bgamari/solar-charger-v2/(list of files, drawings)

Other design files:
solar-charger-2.pcb
