bgamari/solar-charger-v2/firmware/clock.c

#include "clock.h"
#include <libopencm3/cm3/systick.h>
#include <libopencm3/cm3/nvic.h>

volatile uint32_t msTicks;      /* counts 1ms timeTicks */

void init_systick()
{
    systick_set_reload(CLOCKRATE / 8 / 1000);
    systick_interrupt_enable();
    systick_counter_enable();
}

void delay_ms(unsigned int ms) {
    uint32_t curTicks;
    curTicks = msTicks;
    while ((msTicks - curTicks) < ms);
}

void sys_tick_handler(void) {
    msTicks++;
}
