bgamari/solar-charger-v2/(commit log)

2014-06-28 start project solar-charger-2
    [solar-charger-2.sch]
2014-06-29 More shuffling
    [solar-charger-2.sch]
2014-06-29 First pass on board artwork
    [solar-charger-2.pcb, solar-charger-2.sch]
2014-06-29 USB connector added
    [solar-charger-2.pcb, solar-charger-2.sch]
2014-06-29 Add temperature sensor
    [solar-charger-2.pcb, solar-charger-2.sch]
2014-06-29 Fix LED names
    [solar-charger-2.pcb, solar-charger-2.sch]
2014-06-29 Shuffle labels
    [solar-charger-2.pcb]
2014-06-29 Enlarge Panasonic cap footprint
    [solar-charger-2.pcb]
2014-06-30 Add buttons
    [solar-charger-2.pcb, solar-charger-2.sch]
2014-06-30 Clear solder mask under regulators
    [solar-charger-2.pcb]
2014-06-30 Fix component values
    [solar-charger-2.pcb, solar-charger-2.sch]
2014-06-30 Add more notes
    [solar-charger-2.sch]
2014-06-30 More bypassing
    [solar-charger-2.pcb, solar-charger-2.sch]
2014-06-30 More silk shuffling
    [solar-charger-2.pcb]
2014-06-30 Clean up grounds
    [solar-charger-2.pcb]
2014-07-01 Oops, fix TEMP input
    PB2 is unfortunately not an ADC input. Move TEMP to PB0
    [solar-charger-2.pcb, solar-charger-2.sch]
2014-07-01 Add thermistor lookup table
2014-07-01 Mark thermistor lut as static
2014-07-16 Remove VBAT switching
    The high battery voltage made things rather tricky and with enough
    resistance and capacitance the measurement is quite trivial.
    [solar-charger-2.pcb, solar-charger-2.sch]
2014-07-17 Fix divider values
    [solar-charger-2.pcb, solar-charger-2.sch]
2014-07-17 Add UART to JTAG connector
    [solar-charger-2.pcb, solar-charger-2.sch]
2014-07-18 Fix JTAG pinning
    [solar-charger-2.pcb, solar-charger-2.sch]
2014-07-18 Fix silk
    [solar-charger-2.pcb]
2014-07-19 Enlarge board
    [solar-charger-2.pcb]
2014-07-19 Shuffle layout
    [solar-charger-2.pcb]
2014-07-19 More silk
    [solar-charger-2.pcb]
2014-07-19 Show name
    [solar-charger-2.pcb]
2014-07-23 Allow reworking of BOOT0
    [solar-charger-2.pcb]
2014-07-23 Add filter cap to TEMP
    [solar-charger-2.pcb, solar-charger-2.sch]
2014-07-23 Add filter cap to Vin
    [solar-charger-2.pcb, solar-charger-2.sch]
2014-07-24 Simplify traces
    [solar-charger-2.pcb]
2014-07-24 Bump down C1 footprint size
    [solar-charger-2.pcb, solar-charger-2.sch]
2014-07-24 Pull down BOOT1
    [solar-charger-2.pcb, solar-charger-2.sch]
2014-07-24 Add pull-down to BOOT0
    [solar-charger-2.pcb, solar-charger-2.sch]
2014-07-24 Version 3.0
    [solar-charger-2.pcb]
2014-07-27 Fix DAC argument order
    Damn you C
    [charge.c]
2014-07-27 Ensure DAC and ADC clocks get enabled
2014-07-27 timeout: TIM5 apparently doesn't exist on this chip
    Use TIM4 instead.
    [timeout.c]
2014-07-27 Be more careful with ADC power on/off
2014-07-27 adc: Silly logic error
    [adc.c]
2014-07-27 Finally have adc sampling
2014-07-27 adc: Kill dead code
2014-07-27 adc: Fix sampling
    It was still quite wrong
    [adc.c]
2014-07-27 timeout: Move callbacks out of interrupt context
2014-07-27 More ADC fixes
2014-07-28 Rework charging modes
2014-07-28 charge: Fix feedback period
    [charge.c]
2014-07-28 charge: Ensure we reset last_power
    [charge.c]
2014-07-28 usart: Implement printf
2014-07-28 charge: Fix ADC units
    [charge.c]
2014-07-28 timeout: Fix logic error
    [timeout.c]
2014-07-28 charge: Add LOG macro
2014-07-28 charge: Rework
2014-07-28 adc: Manually scan through channels
    I was seeing overflows for unknown reasons
2014-07-28 charge: Disable battery temperature checks for now
2014-07-28 charge: Constraint charge_offset
2014-07-28 charge: Account for voltage sense gain
2014-07-28 adc: Average over samples
2014-07-28 charge: Fix current gain
    [charge.c]
2014-07-29 Reduce current sense resistance
    Previously could only sense up to 164mA
    [solar-charger-2.pcb, solar-charger-2.sch]
2014-07-29 Charging feedback appears to work
2014-07-29 charge: Fix current sense resistor value
    [charge.c]
2014-07-29 Choose more reasonable initial value for charge_offset
2014-08-04 charge: Current in microamps
2014-08-04 charge: Make threshold power configurable
2014-08-04 Be smarter about initialization
    Start offset near battery voltage
2014-08-04 charge: Document variables
2014-08-04 charge: Ensure perturbation sign is correct after reset
    [charge.c]
2014-08-04 charge: Kill dead code
2014-08-05 charge: Refactor ADC channel mappings and sample Vin
2014-08-05 Increase charge restart time
2014-08-05 charge: Factor out sensor sampling
2014-08-05 charge: Export sample cache
2014-08-05 Use button to query charge state
2014-08-05 Fix R6 value
    2.2kohm is close enough to 2.5kohm
    [solar-charger-2.pcb, solar-charger-2.sch]
2014-08-09 Use 56k and 10k for USB regulator
    [solar-charger-2.pcb, solar-charger-2.sch]
2014-08-09 charge: Update pinning
2014-08-09 adc: Ensure last sample get written
2014-08-09 charge: Add debug output
2014-08-09 charge: Add newline
2014-08-09 Fix charge voltage to offset calculation
    [charge.c]
2014-08-09 charge: Fix charge_en pin
    [charge.c]
2014-08-09 charge: Reset to slightly above battery voltage
    [charge.c]
2014-08-09 charge: Add manual mode
2014-08-09 usart: thread safety
2014-08-10 More room around 0603s
    [solar-charger-2.pcb]
2014-08-13 Kill CHARGE_EN pin
    This broke the charge regulator as it dragged the EN pin to 3.3V.
    Unfortunately the maximum pin voltage is 5V, so we can't use the open
    drain mode. Oh well, I really didn't need CHARGE_EN anyways as we can
    just adjust the voltage setpoint
    [solar-charger-2.pcb, solar-charger-2.sch]
2014-08-14 Fix trickle current setpoint
    [charge.c]
2014-08-19 charge: Set maximum charge regulator current limit
2014-08-19 charge: Move termination checks after feedback
2014-08-19 Only do temperature check which charging
2014-08-19 main: Setup button pullups
2014-08-19 start charging on button 2 press
2014-08-23 sch: Add filtering for charge current
    [solar-charger-2.sch]
2014-08-23 pcb: Add filtering for current sense
    [solar-charger-2.pcb]
2014-08-23 Expose only SWD pins
    [solar-charger-2.pcb, solar-charger-2.sch]
2014-08-23 Expose I2C pins
    [solar-charger-2.pcb, solar-charger-2.sch]
2014-08-23 Add missing via
    [solar-charger-2.pcb]
2014-08-23 Flip buttons and USB connector
    [solar-charger-2.pcb]
2014-08-23 Fix some DRC issues
    [solar-charger-2.pcb]
2014-08-23 Rework silk
    [solar-charger-2.pcb]
2014-08-24 3.3uH not 3.3H
    [solar-charger-2.sch]
2014-08-24 charge: Expose some MPPT parameters
2014-08-25 Determine debug mode by button at boot
2014-08-25 Add target pv voltage to be adjusted with console
